akostibas/projector-off-o-matic/images/02 - trinket assembled.jpeg

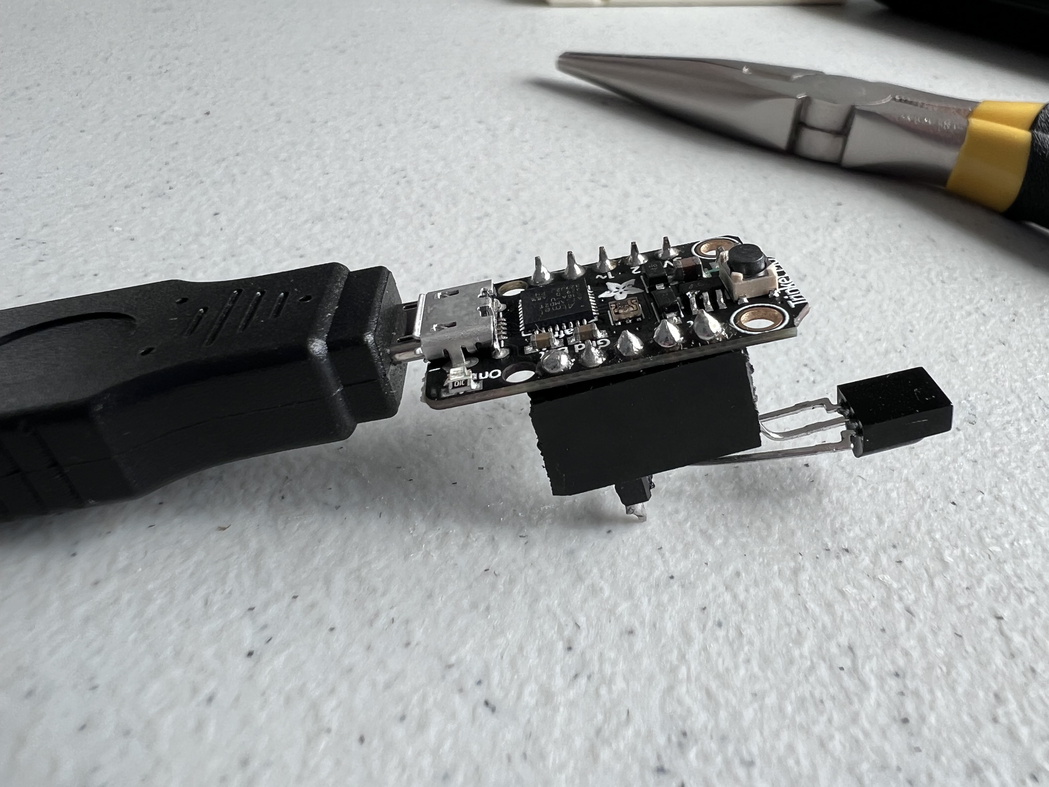
images/02 - trinket assembled.jpeg
